Ad1thh/Final-Project-EV/RV32E-fpga-impl/RV32E-fpga-impl.runs/impl_1/.init_design.begin.rst

<?xml version="1.0"?>
<ProcessHandle Version="1" Minor="0">
    <Process Command=".planAhead." Owner="hp" Host="ADITHYAN" Pid="23976">
    </Process>
</ProcessHandle>
