Ad1thh/Final-Project-EV/clockInfo.txt

-------------------------------------
| Tool Version : Vivado v.2025.2
| Date         : Wed Oct  7 10:22:59 2026
| Host         : ACE
| Design       : design_1
| Device       : xc7a100t-csg324-1--
-------------------------------------

For more information on clockInfo.txt clock routing debug file see https://support.xilinx.com/s/article/000035660?language=en_US
