Ad1thh/Final-Project-EV/RV32E-fpga-impl/RV32E-fpga-impl.runs/impl_1/.vivado.begin.rst

<?xml version="1.0"?>
<ProcessHandle Version="1" Minor="0">
    <Process Command="vivado.bat" Owner="hp" Host="ADITHYAN" Pid="10576" HostCore="12" HostMemory="016831893504">
    </Process>
</ProcessHandle>
