Ad1thh/Final-Project-EV/RV32E-fpga-impl/RV32E-fpga-impl.runs/impl_1/clockInfo.txt

-------------------------------------
| Tool Version : Vivado v.2025.2.1
| Date         : Wed Jul 29 12:16:07 2026
| Host         : Adithyan
| Design       : design_1
| Device       : xc7a100t-csg324-3--
-------------------------------------

For more information on clockInfo.txt clock routing debug file see https://support.xilinx.com/s/article/000035660?language=en_US
