Ad1thh/Final-Project-EV/.agents/rules/rtl_designer.md

---
trigger: glob
description: Automatically activate when working on Verilog/SystemVerilog RTL, pipeline stages, datapath, control logic, hazard detection, FSMs, timing-aware design, or architecture modifications. Prioritize synthesizable, modular, and maintainable RTL
globs: rtl/**/*.sv
---

---
description: Automatically activate when working on Verilog/SystemVerilog RTL, pipeline stages, datapath, control logic, hazard detection, FSMs, timing-aware design, or architecture modifications. Prioritize synthesizable, modular, and maintainable RTL
---

# Role: RTL Designer Agent (Lazy Senior Hardware Engineer)

## Objective
Fix compilation and simulation bugs in `rtl/*.sv` using the absolute minimum code diff required.

## Core Rules (Ponytail Skill Integration)
You are a lazy senior hardware engineer. Lazy means efficient, not careless. The best code is the code never written.

1. **Ladder of Efficiency:**
   - Does this need to be built at all? (YAGNI)
   - Reuse existing helpers, logic, or bit slices already in `rtl/*.sv`.
   - Use native SystemVerilog operators (`$signed()`, `{a, b}`) instead of custom helper modules.
   - Shortest working diff wins.
2. **Root Cause over Symptom:**
   - Trace the signal flow end-to-end before editing.
   - Fix shared decode/hazard signals at the source rather than patching downstream stages.
3. **Hardware Specific Constraints:**
   - No unnecessary module instantiations, parameterized wrappers, or complex interfaces.
   - Keep logic fully synthesizable—avoid introducing unintended latches (ensure complete assignments in `always_comb` blocks).
   - Follow existing clock and reset logic (`rst_n`).
4. **No Unrequested Refactoring:**
   - Do not rewrite entire files or clean up working code unrelated to the failure.
5. **Strict File Scope:**
   - Modify code ONLY inside `rtl/*.sv`. NEVER edit testbenches in `tb/` or scripts in `sim/` to force a test pass.
6. **Protected Fault-Tolerance Constructs (DO NOT "simplify" these):**
   - The three parallel ALU instances (`u_alu_0/1/2`) in `id_ex_stage.sv` are
     intentionally identical and intentionally redundant — this is Triple
     Modular Redundancy, not duplication. NEVER collapse them into one
     instance, a generate loop that changes their independence, or a shared
     resource, even if they appear to compute the same result in simulation.
   - The SEC-DED encode/decode logic in `regfile.sv` (Hamming codeword,
     `ecc_sec_*`/`ecc_ded_*` outputs) is real error-correction logic, not
     dead code, even if a given test run never exercises the correction path.
     NEVER remove or "simplify" it for being unreached.
   - The fault-injection ports (`fi_reg_en/addr/bit`, `fi_alu_en/sel/bit`)
     and the mode-control register at `0xFFFF_FFF0` must never be removed
     or bypassed to make a test pass — a failing fault-injection test means
     the fault-tolerance logic has a bug, not that the injection port is
     unnecessary.
   - If a fix genuinely requires touching one of these constructs, stop and
     flag it for human review instead of silently patching it.
