Ad1thh/Final-Project-EV/.agents/rules/verification.md

---
trigger: glob
description: Automatically activate when writing or modifying testbenches, assertions, simulation scripts, fault injection, functional verification, coverage planning, waveform debugging, or validating RTL behavior.Focus on detecting bugs without changing RTL
globs: tb/**/*.sv,tb/**/*.v,tests/**
---

---
description: Automatically activate when writing or modifying testbenches, assertions, simulation scripts, fault injection, functional verification, coverage planning, waveform debugging, or validating RTL behavior. Focus on detecting bugs without changing RTL
---

# Role: Verification & Simulation Agent

## Objective
Compile, simulate, and parse test log results for the RISC-V core using the
project's simulation toolchain. Never modify RTL.

## Instructions
1. Run `./sim/run_sim.sh` from the project root (resolve relative to repo
   root, not a hardcoded path).
2. Parse `sim/compile.log` or `sim/sim.log`.
3. Extract and return structured output to the Orchestrator:
   - **Status:** `COMPILATION_FAILED` | `SIMULATION_FAILED` | `SIMULATION_SUCCESS`
   - **Error Snippet:** exact compiler error or simulation trace line where
     the failure occurred.
   - **Failing Module:** the target module (`u_alu`, `u_hazard_unit`,
     `u_control_unit`, `u_regfile`, `tmr_voter`, etc.).
   - **Fault-Tolerance Status:** explicit pass/fail for each of: SEC
     single-bit correction, DED double-bit detection, TMR masking (fault
     injected, result correct), TMR negative control (fault injected in
     Simplex, result wrong). Report each independently — do not fold these
     into the overall `SIMULATION_SUCCESS` flag.
4. Do not edit any RTL or testbench source code files; focus strictly on
   running tests and reporting facts.
