Ad1thh/Final-Project-EV/RV32E-fpga-impl/RV32E-fpga-impl.runs/synth_1/.Xil/fpga_top_propImpl.xdc

set_property SRC_FILE_INFO {cfile:C:/Users/hp/Downloads/Final_Project/constraints/nexys4.xdc rfile:../../../../constraints/nexys4.xdc id:1} [current_design]
set_property src_info {type:XDC file:1 line:11 export:INPUT save:INPUT read:READ} [current_design]
set_property -dict { PACKAGE_PIN E3    IOSTANDARD LVCMOS33 } [get_ports { CLK100MHZ }];
set_property src_info {type:XDC file:1 line:17 export:INPUT save:INPUT read:READ} [current_design]
set_property -dict { PACKAGE_PIN E16   IOSTANDARD LVCMOS33 } [get_ports { CPU_RESETN }];
set_property src_info {type:XDC file:1 line:22 export:INPUT save:INPUT read:READ} [current_design]
set_property -dict { PACKAGE_PIN T8   IOSTANDARD LVCMOS33 } [get_ports { LED[0]  }];
set_property src_info {type:XDC file:1 line:23 export:INPUT save:INPUT read:READ} [current_design]
set_property -dict { PACKAGE_PIN V9   IOSTANDARD LVCMOS33 } [get_ports { LED[1]  }];
set_property src_info {type:XDC file:1 line:24 export:INPUT save:INPUT read:READ} [current_design]
set_property -dict { PACKAGE_PIN R8   IOSTANDARD LVCMOS33 } [get_ports { LED[2]  }];
set_property src_info {type:XDC file:1 line:25 export:INPUT save:INPUT read:READ} [current_design]
set_property -dict { PACKAGE_PIN T6   IOSTANDARD LVCMOS33 } [get_ports { LED[3]  }];
set_property src_info {type:XDC file:1 line:26 export:INPUT save:INPUT read:READ} [current_design]
set_property -dict { PACKAGE_PIN T5   IOSTANDARD LVCMOS33 } [get_ports { LED[4]  }];
set_property src_info {type:XDC file:1 line:27 export:INPUT save:INPUT read:READ} [current_design]
set_property -dict { PACKAGE_PIN T4   IOSTANDARD LVCMOS33 } [get_ports { LED[5]  }];
set_property src_info {type:XDC file:1 line:28 export:INPUT save:INPUT read:READ} [current_design]
set_property -dict { PACKAGE_PIN U7   IOSTANDARD LVCMOS33 } [get_ports { LED[6]  }];
set_property src_info {type:XDC file:1 line:29 export:INPUT save:INPUT read:READ} [current_design]
set_property -dict { PACKAGE_PIN U6   IOSTANDARD LVCMOS33 } [get_ports { LED[7]  }];
set_property src_info {type:XDC file:1 line:30 export:INPUT save:INPUT read:READ} [current_design]
set_property -dict { PACKAGE_PIN V4   IOSTANDARD LVCMOS33 } [get_ports { LED[8]  }];
set_property src_info {type:XDC file:1 line:31 export:INPUT save:INPUT read:READ} [current_design]
set_property -dict { PACKAGE_PIN U3   IOSTANDARD LVCMOS33 } [get_ports { LED[9]  }];
set_property src_info {type:XDC file:1 line:32 export:INPUT save:INPUT read:READ} [current_design]
set_property -dict { PACKAGE_PIN V1   IOSTANDARD LVCMOS33 } [get_ports { LED[10] }];
set_property src_info {type:XDC file:1 line:33 export:INPUT save:INPUT read:READ} [current_design]
set_property -dict { PACKAGE_PIN R1   IOSTANDARD LVCMOS33 } [get_ports { LED[11] }];
set_property src_info {type:XDC file:1 line:34 export:INPUT save:INPUT read:READ} [current_design]
set_property -dict { PACKAGE_PIN P5   IOSTANDARD LVCMOS33 } [get_ports { LED[12] }];
set_property src_info {type:XDC file:1 line:35 export:INPUT save:INPUT read:READ} [current_design]
set_property -dict { PACKAGE_PIN U1   IOSTANDARD LVCMOS33 } [get_ports { LED[13] }];
set_property src_info {type:XDC file:1 line:36 export:INPUT save:INPUT read:READ} [current_design]
set_property -dict { PACKAGE_PIN R2   IOSTANDARD LVCMOS33 } [get_ports { LED[14] }];
set_property src_info {type:XDC file:1 line:37 export:INPUT save:INPUT read:READ} [current_design]
set_property -dict { PACKAGE_PIN P2   IOSTANDARD LVCMOS33 } [get_ports { LED[15] }];
