Ad1thh/Final-Project-EV/(commit log)

2026-07-24 feat: implement synthesizable 3-stage pipelined RV32E processor core with hazard unit and control logic
2026-07-25 Add riscv-arch-test files directly to main repo
    [D.csv, ExceptionsVf.csv, ExceptionsVfmin.csv, ExceptionsVls.csv, ExceptionsVx.csv, F.csv, I.csv, M.csv]
2026-07-25 refactor: remove case-colliding linux header duplicates
2026-07-25 fixed-Duplicate forwarding logic,No mode-control register,No fault-injection ports,SEC-DED and TMR/voter don't exist in the code
    [alu.sv, control_unit.sv, hazard_unit.sv, id_ex_stage.sv, regfile.sv, riscv_core_top.sv, tb_riscv_core_top.sv, tmr_voter.sv]
2026-08-05 feat: implement RISC-V writeback stage, adaptive redundancy controller, and supporting testbench infrastructure
2026-08-19 chore: remove massive test suites from tracking and fix stress test PC expectation
    [D.csv, ExceptionsVf.csv, ExceptionsVfmin.csv, ExceptionsVls.csv, ExceptionsVx.csv, F.csv, I.csv, M.csv]
2026-08-23 feat: Implement and integrate UART TX module
2026-10-07 Convert Architecture to SoC: Zynq PS to AXI GPIO for on-board USB-UART bridging
2026-10-08 Make UART terminal open by default for visibility
2026-10-08 Move Terminal button down for better accessibility
2026-10-09 fix(dashboard, rtl): resolve synthesis multi-driver net, sync hardware telemetry and layout
    [fpga_top.sv, hil_controller.sv, main.c, zybo_z7.xdc]
2026-10-09 feat(asic): add Cadence Genus synthesis and Innovus flow packages with preservation rules
2026-10-09 feat(cadence): configure 90nm slow.lib foundry target library as default in run_genus_syn.tcl
2026-10-13 feat: add hardware JTAG-to-MIO48 bridge scripts and constraints for Zybo FPGA board
2026-10-13 feat(cadence): clean dedicated ASIC branch containing only RTL, testbenches, and Cadence flow
2026-10-13 docs: rewrite README.md specifically for Cadence ASIC Genus and Innovus flow
2026-10-13 fix(cadence): add setup_cadence_env.sh, fix genus script flow and sdc bus constraints
2026-10-14 feat(cadence): add synthesized gate-level netlist and QoR reports for 90nm ASIC flow
2026-10-14 Complete Cadence Innovus P&R flow for RV32E fault-tolerant core
    - Executed floorplanning (70% density), power grid (M5/M6 rings, M1 followpins)
    - Placed 11,501 standard cells with zero routing congestion
    - Synthesized and balanced clock tree across 852 sinks using CCOpt
    - Completed detailed NanoRoute with 0 DRC violations and clean LVS/connectivity
    - Verified post-route timing (WNS: +0.249 ns on reg-to-reg paths at 100 MHz, 0 DRVs)
    - Total post-route power: 6.405 mW (0.9V GPDK 90nm slow corner)
    - Exported routed Verilog netlist, complete layout DEF, encrypted database, and QoR reports
2026-10-14 Remove UART modules and add top-level I/O pin placement in Innovus P&R
2026-10-14 Update high-resolution CAD physical layout and floorplan hierarchy images
